bansalsaksham/ARIS/3MT Presentation Slides - A.R.I.S..pdf

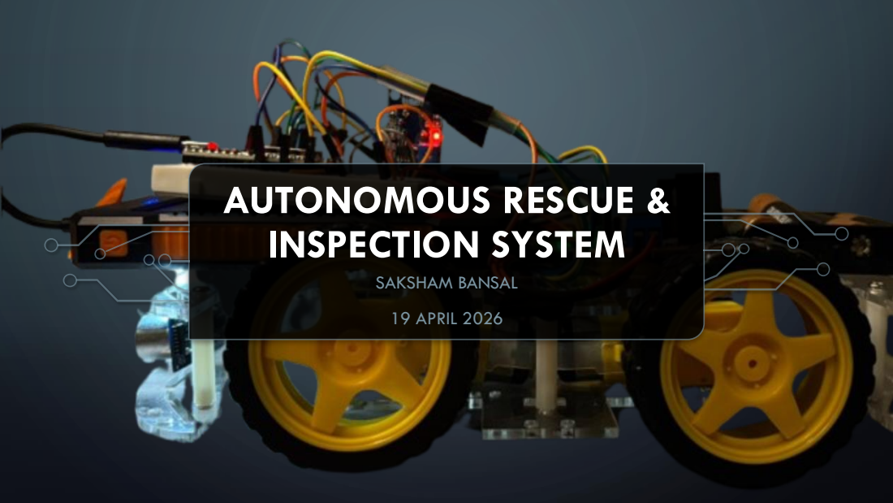
[picture p1: page 1]
AUTONOMOUS RESCUE & INSPECTION SYSTEM; SAKSHAM BANSAL; 19 APRIL 2026

NAVIGATING UNSTABLE DISASTER ZONES REQUIRES RELIABLE POWER AND PRECISE SENSOR INTEGRATION.

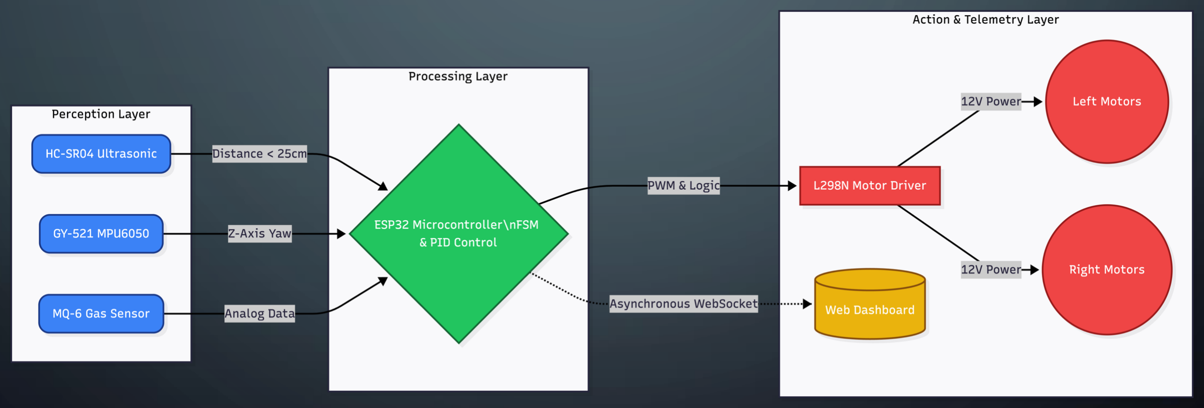
[picture p2: figure]

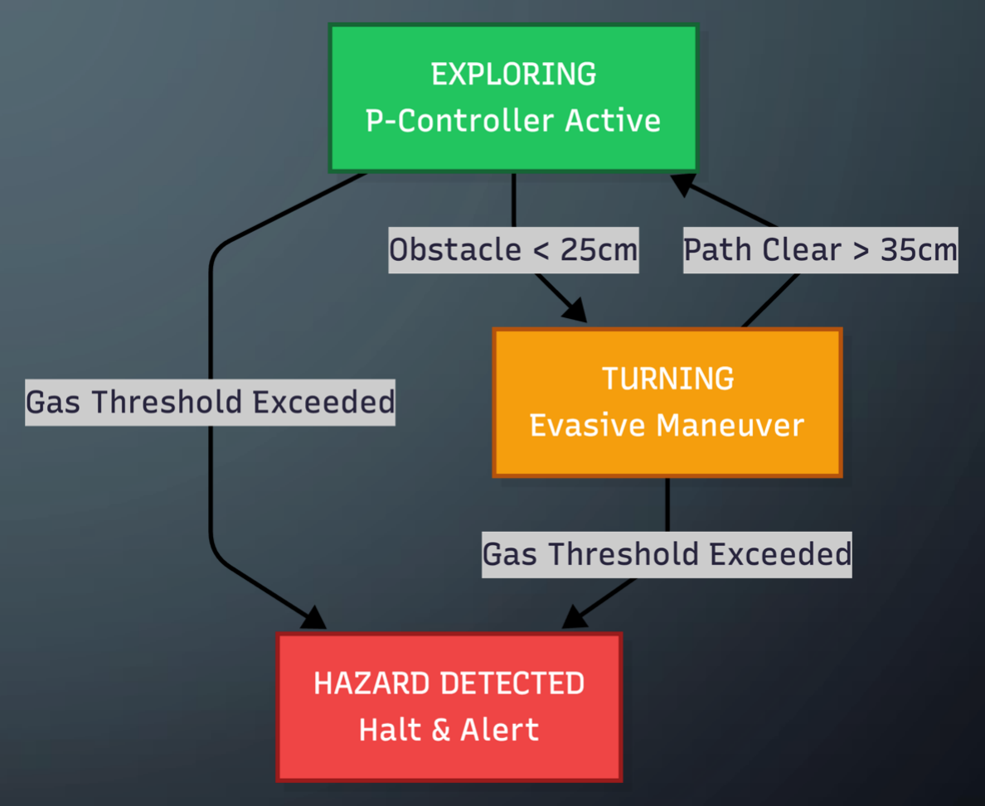
[picture p3: figure]

A NON-BLOCKING
FINITE STATE
MACHINE PROCESSES
RAW TELEMETRY TO
EXECUTE
AUTONOMOUS
EVASIVE MANEUVERS.

A.R.I.S. PROVES THAT LOW-COST, ASYNCHRONOUS SYSTEMS CAN SAFELY PROVIDE REAL-TIME SITUATIONAL AWARENESS.

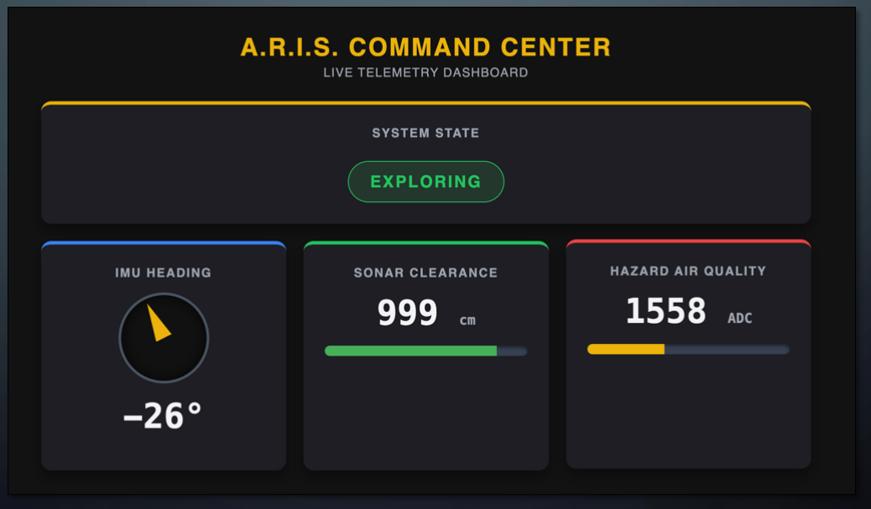
[picture p4: figure]
